cafsanchezdi/Proyecto-Rob-23-2/Imgs/DiagramaCotrolGripper.png

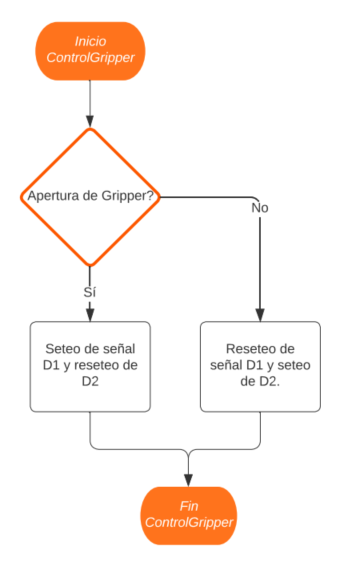
Imgs/DiagramaCotrolGripper.png
