cafsanchezdi/Proyecto-Rob-23-2/Imgs/Estant1.png

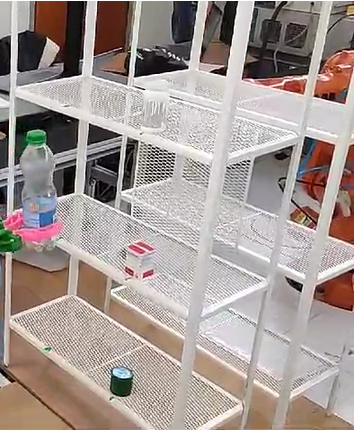
Imgs/Estant1.png
