cafsanchezdi/Proyecto-Rob-23-2/Imgs/PlanoEstant.png

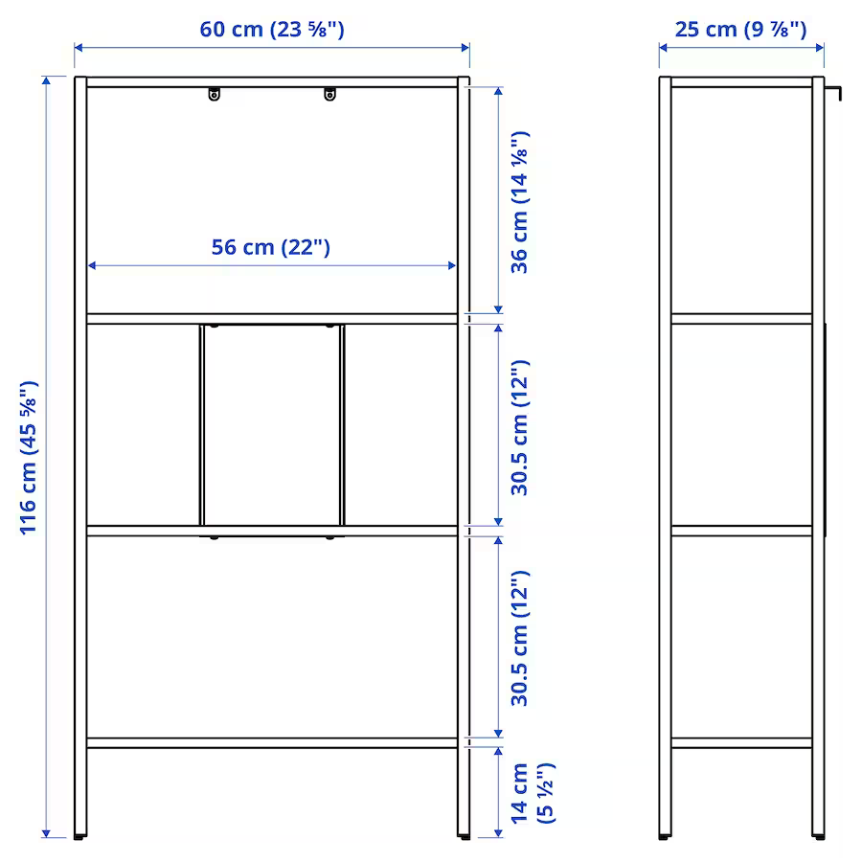
Imgs/PlanoEstant.png
