cafsanchezdi/Proyecto-Rob-23-2/Imgs/RobotStudio.jpg

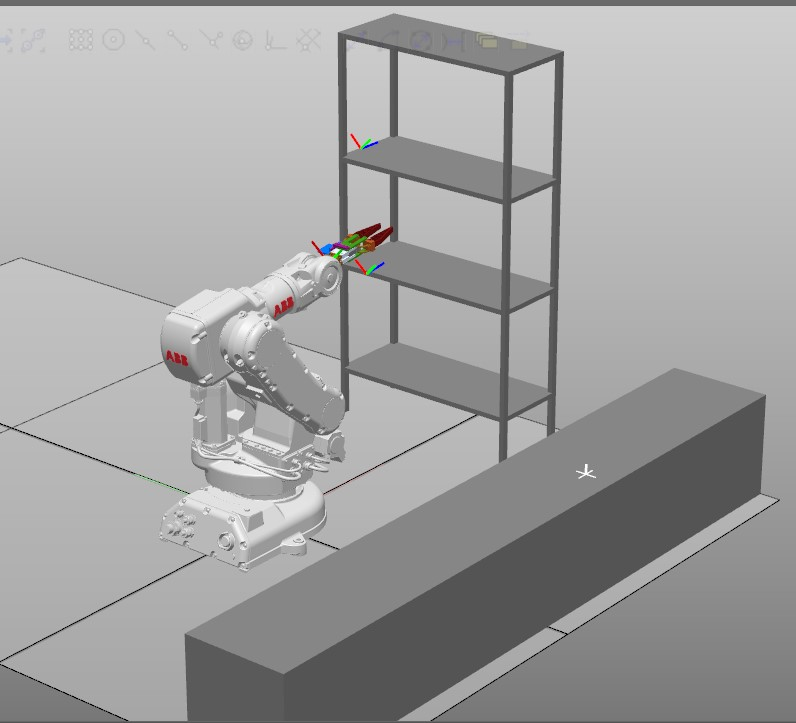
Imgs/RobotStudio.jpg
