cafsanchezdi/Proyecto-Rob-23-2/Imgs/RobProjHome.png

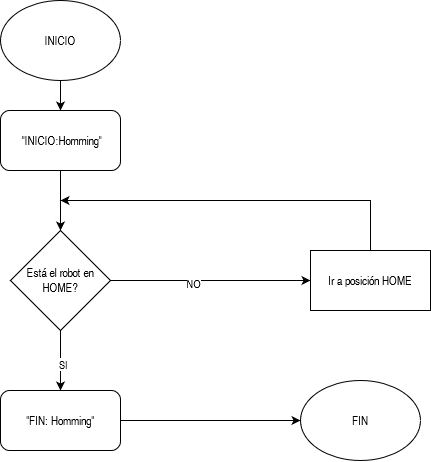
Imgs/RobProjHome.png
