cafsanchezdi/Proyecto-Rob-23-2/CADs/Estanteria.stl

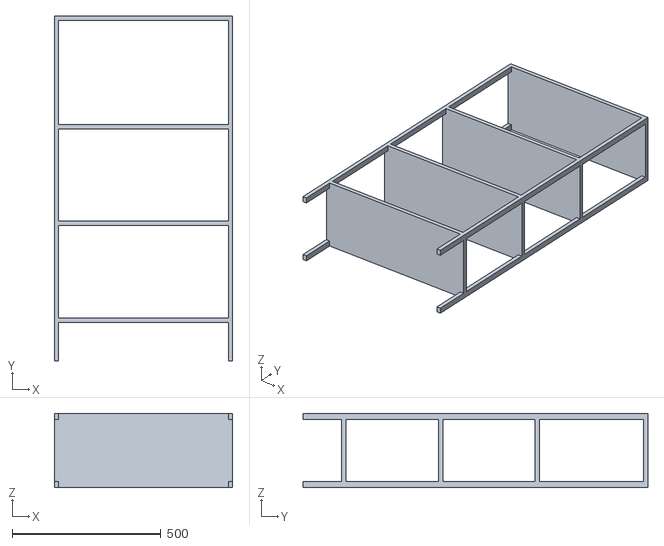
[picture p19: CAD file, 2023-12-06]
CADs/Estanteria.stl
600.0 x 1160.0 x 250.0
