cafsanchezdi/Proyecto-Rob-23-2/CADs/Gripper/STL/Dedo.stl

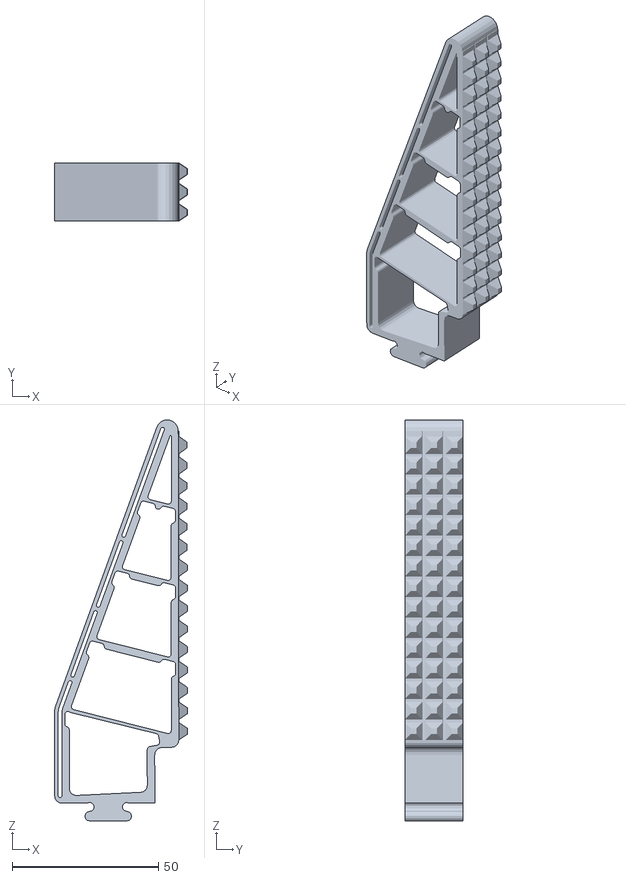
[picture p20: CAD file, 2023-12-07]
CADs/Gripper/STL/Dedo.stl
45.6 x 20.0 x 137.3
