cafsanchezdi/Proyecto-Rob-23-2/CADs/Gripper/STL/Soporte Piston.stl

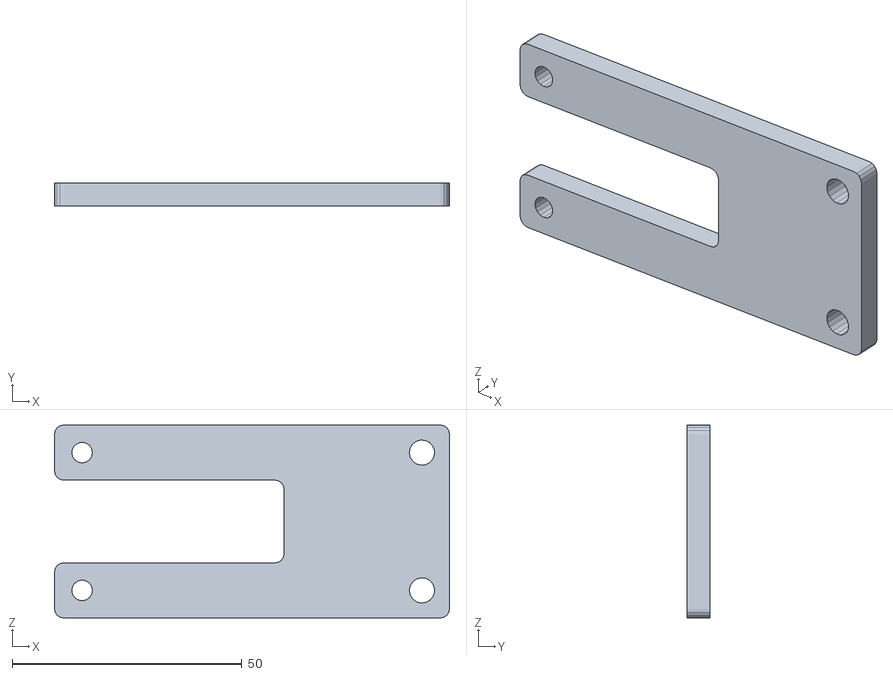
[picture p21: CAD file, 2023-12-06]
CADs/Gripper/STL/Soporte Piston.stl
86.0 x 5.00 x 42.0
