cafsanchezdi/Proyecto-Rob-23-2/CADs/Gripper/STL/Soporte Dedo.stl

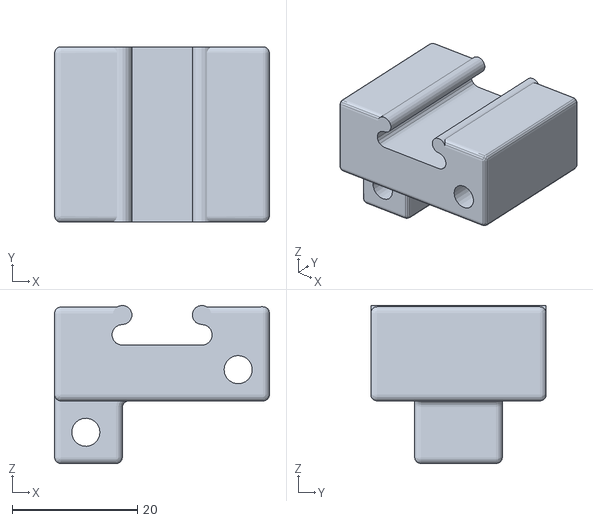
[picture p22: CAD file, 2023-12-06]
CADs/Gripper/STL/Soporte Dedo.stl
34.3 x 28.0 x 25.3
