cafsanchezdi/Proyecto-Rob-23-2/CADs/Gripper/STL/Flanche.stl

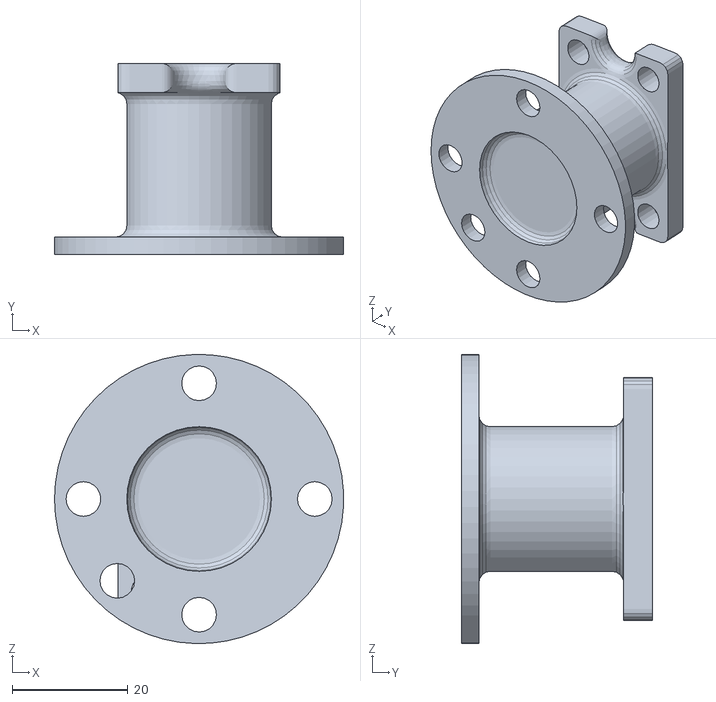
[picture p23: CAD file, 2023-12-06]
CADs/Gripper/STL/Flanche.stl
50.0 x 33.0 x 50.0
