cafsanchezdi/Proyecto-Rob-23-2/CADs/Gripper/STL/Union.stl

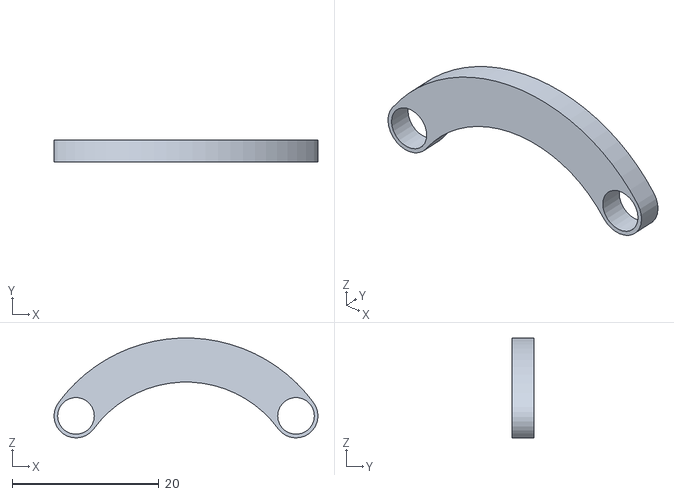
[picture p24: CAD file, 2023-12-06]
CADs/Gripper/STL/Union.stl
36.0 x 3.00 x 13.6
