cafsanchezdi/Proyecto-Rob-23-2/CADs/Gripper/STL/Soporte Chupa.stl

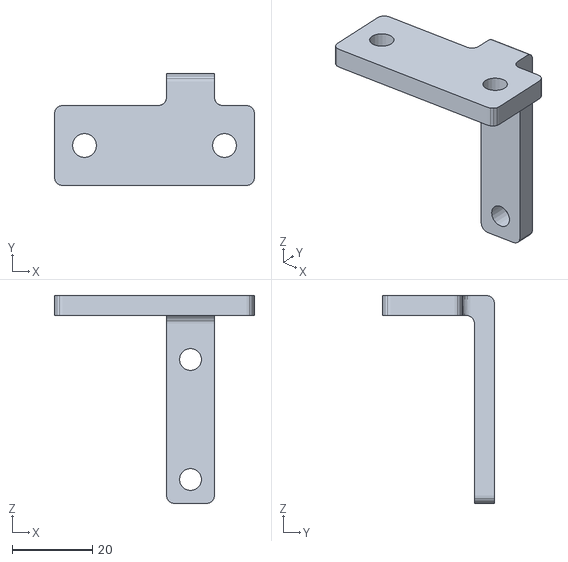
[picture p25: CAD file, 2023-12-06]
CADs/Gripper/STL/Soporte Chupa.stl
50.0 x 28.0 x 52.0
