cafsanchezdi/Proyecto-Rob-23-2/CADs/Gripper/STL/Dedo - Copy.stl

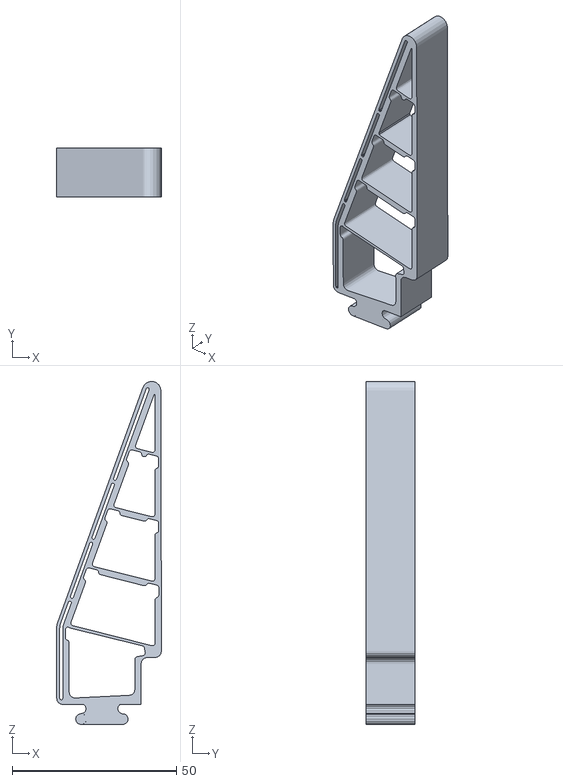
[picture p26: CAD file, 2023-12-06, an earlier design]
CADs/Gripper/STL/Dedo - Copy.stl
31.9 x 15.0 x 104.5
