cafsanchezdi/Proyecto-Rob-23-2/Imgs/Prueba agarre noxpirin.jpeg

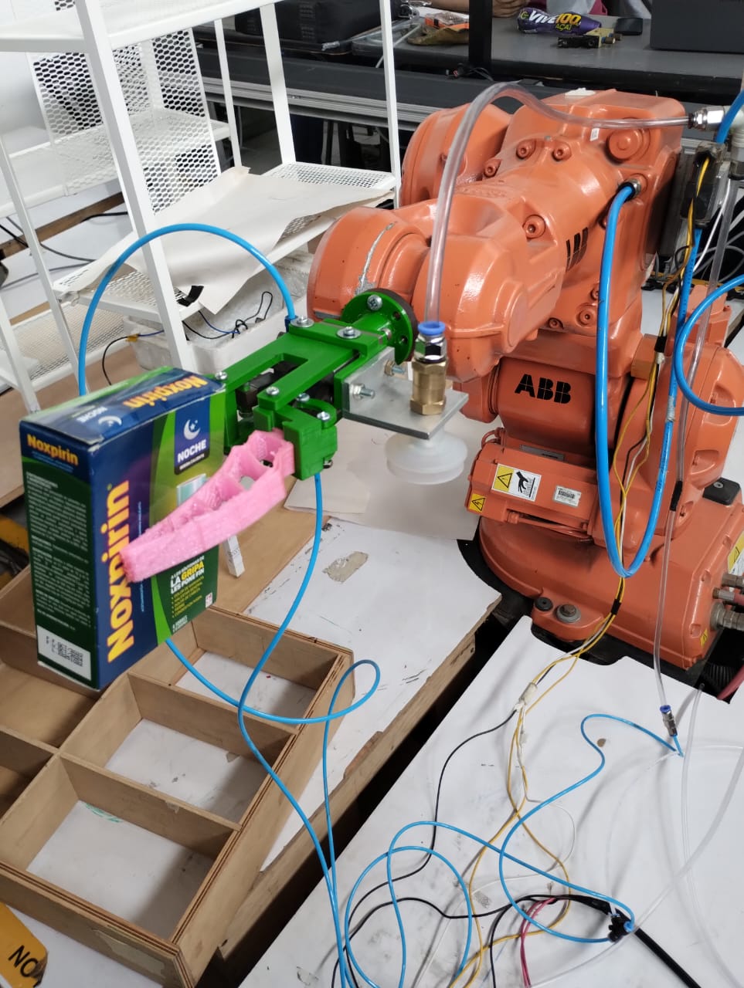
Imgs/Prueba agarre noxpirin.jpeg
