cafsanchezdi/Proyecto-Rob-23-2/Imgs/Prueba agarre pastillas.jpeg

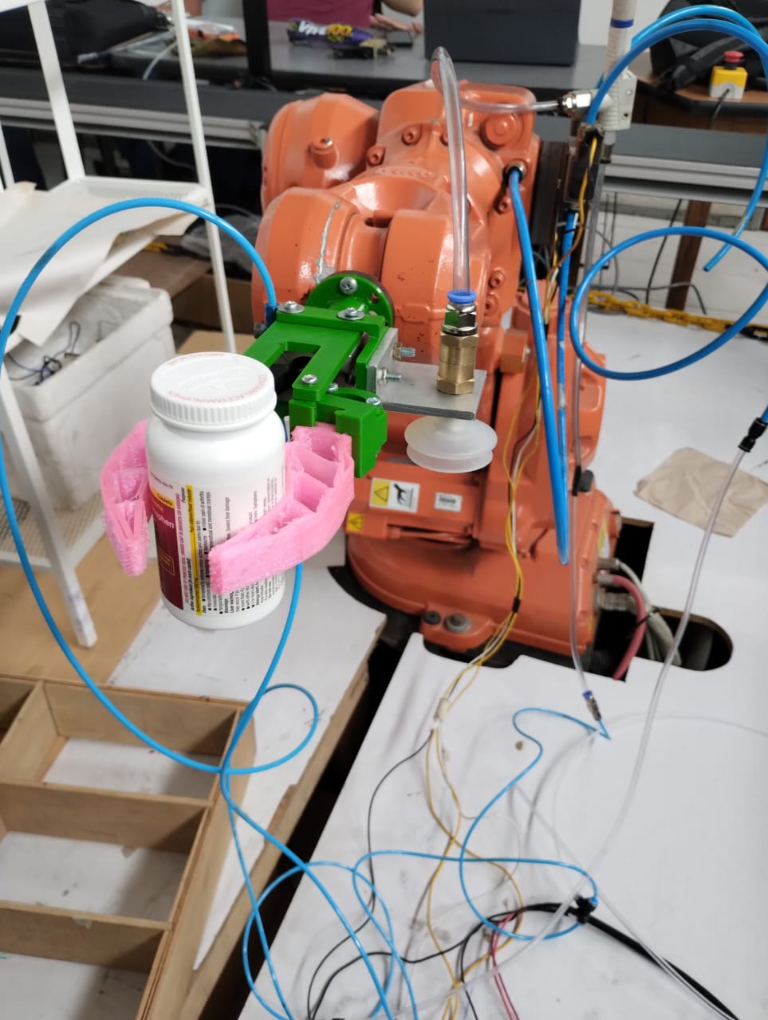
Imgs/Prueba agarre pastillas.jpeg
