cafsanchezdi/Proyecto-Rob-23-2/CADs/Gripper/Planos/Plano Dedo.pdf

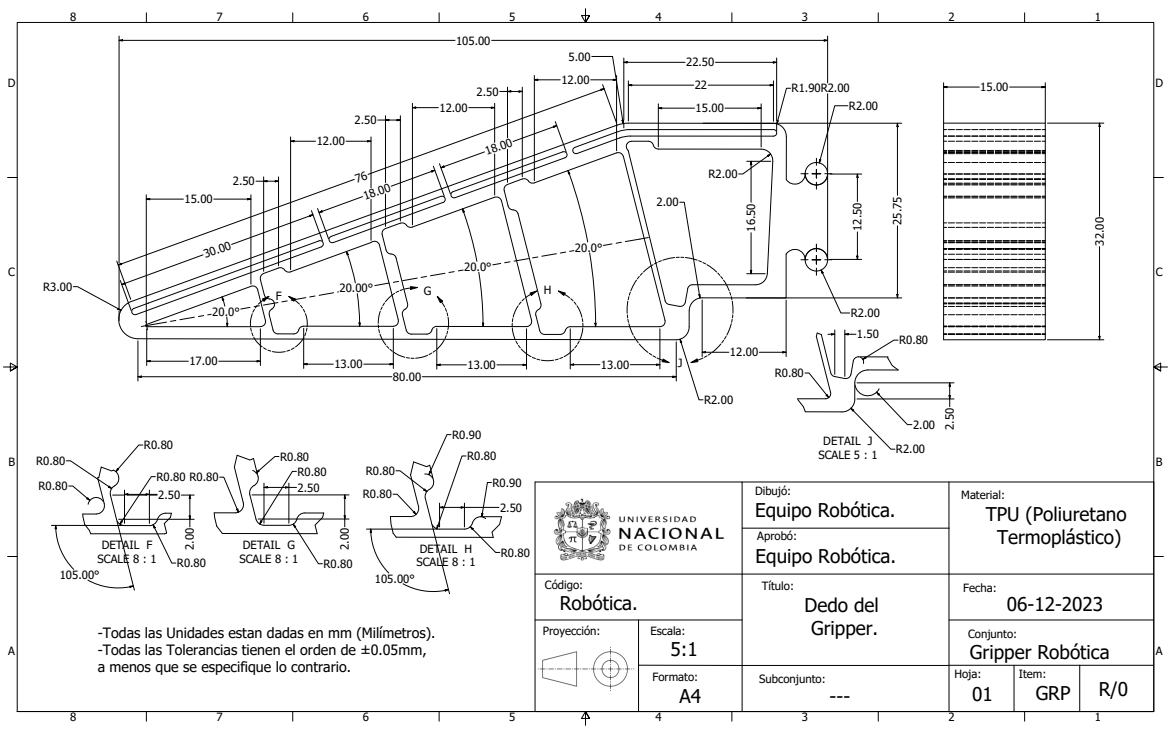
[picture p29: page 1]
DETAIL F SCALE 8 : 1; DETAIL G SCALE 8 : 1; DETAIL H SCALE 8 : 1; DETAIL J SCALE 5 : 1; Equipo Robótica.; TPU (Poliuretano

Código: Robótica. | Título: Dedo del Gripper. | Fecha: 06-12-2023

Proyección: | Escala: 5:1 | | Conjunto: Gripper Robótica

-Todas las Unidades estan dadas en mm (Milímetros).
-Todas las Tolerancias tienen el orden de ±0.05mm,
a menos que se especifique lo contrario.

Formato: A4 | Subconjunto: --- | Hoja: 01 | Item: GRP | R/0
