cafsanchezdi/Proyecto-Rob-23-2/CADs/Gripper/Planos/Plano Soporte Chupa.pdf

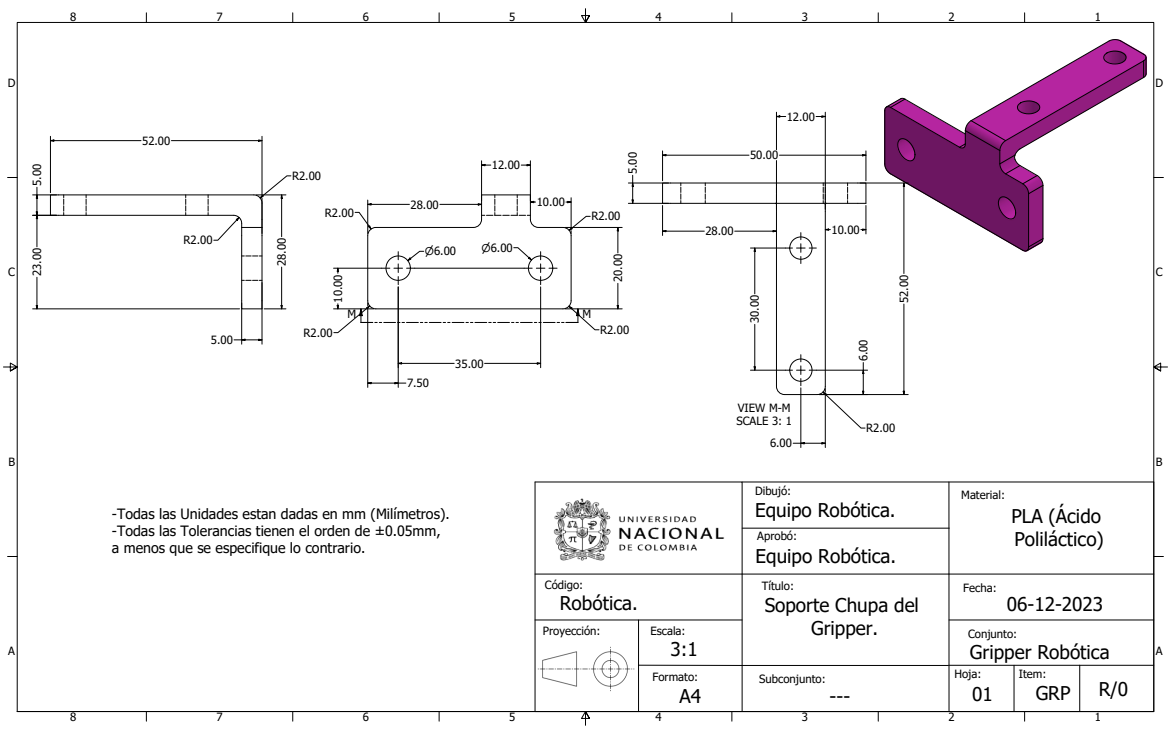
[picture p31: page 1]
VIEW M-M SCALE 3: 1; Equipo Robótica.; PLA (Ácido

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

Código: Robótica. | Título: Soporte Chupa del Gripper. | Fecha: 06-12-2023

Proyección: | Escala: 3:1 | | Conjunto: Gripper Robótica

Formato: A4 | Subconjunto: --- | Hoja: 01 | Item: GRP | R/0
