cafsanchezdi/Proyecto-Rob-23-2/CADs/Gripper/Planos/Plano Soporte Pistón.pdf

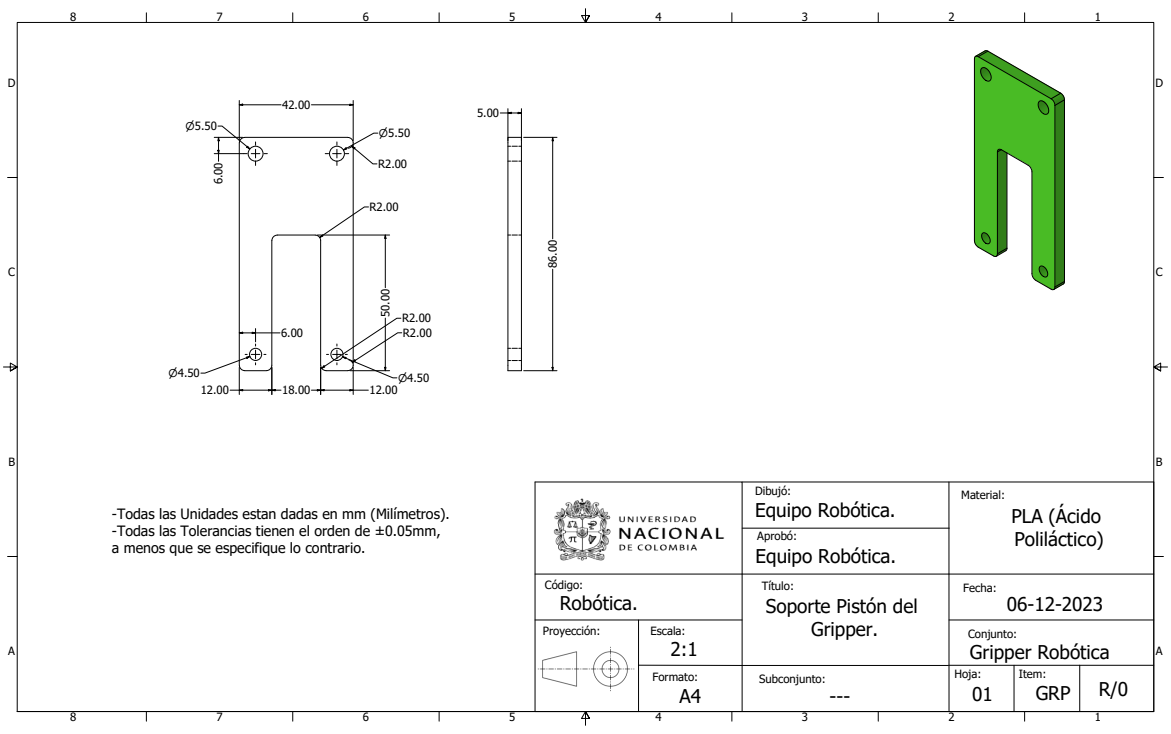
[picture p32: page 1]
Equipo Robótica.; PLA (Ácido

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

Código: Robótica. | Título: Soporte Pistón del Gripper. | Fecha: 06-12-2023

Proyección: | Escala: 2:1 | | Conjunto: Gripper Robótica

Formato: A4 | Subconjunto: --- | Hoja: 01 | Item: GRP | R/0
